waterloo-rocketry/Payload-2018/Software outline.docx

Software outline

Recovery board

3 main states, idle, active and armed

Idle State

- Only the Arduino and xbee are on

Active state

- Recovery Arduino is on, power is supplied to instrumentation board
- Stratologger is off
- Used to allow GPS to get a lock, and test datalogging

Armed state

- Same as active state but with stratologger on

Main loop

1. Check for data from transponder
2. If there is data
  a. Parse command from data
  b. If command is a state change
    i. Change state to new state
  c. Else do nothing
3. Check state
4. If state is idle
  a. Send
