waterloo-rocketry/Payload-2018/BOM.xlsx

Digikey Part # | Description | Quantity | Price per | Source | Total
 | Arduino nano 3 pack | 1 | $17.98 | https://www.amazon.ca/Gikfun-ATmega328-Micro-controller-Arduino-EK1620x3/dp/B00WS81CC2 | $17.98
CPC1002NTR | Solid State Relay | 3 | $2.38 | https://www.digikey.ca/product-detail/en/ixys-integrated-circuits-division/CPC1002NTR/CLA230CT-ND/1212841 | $7.14
XBP9B-XCUT-001 | Xbee | 3 | $54.30 | https://www.digikey.ca/product-detail/en/digi-international/XBP9B-XCUT-001/602-1295-ND/3043287 | $162.90
R-78E3.3-0.5 | 3.3V linear regulator | 3 | $3.71 | https://www.digikey.ca/products/en?keywords=R-78E3.3-0.5 | $11.13
PI4ULS5V201TAEX | Bidirectional shifter | 13 | $0.66 | https://www.digikey.ca/product-detail/en/diodes-incorporated/PI4ULS5V201TAEX/PI4ULS5V201TAEXCT-ND/4147077 | $8.58
08-50-0114 | 2 pin Molex pins | 36 | $0.24 | https://www.digikey.ca/product-detail/en/molex-llc/08-50-0114/WM1114-ND/26475 | $8.64
22-23-2021 | 2 pin molex male | 18 | $0.22 | https://www.digikey.ca/product-detail/en/molex-llc/22-23-2021/WM4200-ND/26667 | $3.96
22-01-2027 | 2 pin molex female | 18 | $0.14 | https://www.digikey.ca/product-detail/en/molex-llc/22-01-2027/WM2011-ND/171991 | $2.52
XC6201P302MR-G | 3V linear regulator | 2 | $0.98 | https://www.digikey.ca/product-detail/en/torex-semiconductor-ltd/XC6201P302MR-G/893-1189-1-ND/3906799 | $1.96
TPS71518DCKR | 1.8V linear regulator | 2 | $1.32 | https://www.digikey.ca/product-detail/en/texas-instruments/TPS71518DCKR/296-18731-1-ND/863553 | $2.64
 | MicroSD card reader | 2 | $9.68 | https://www.adafruit.com/product/254 | $19.36
 | GPS breakout board | 2 | $51.58 | https://www.adafruit.com/product/746 | $103.16
MS5607-02BA03 | Pressure Sensor | 1 | $4.42 | https://www.digikey.ca/product-detail/en/te-connectivity-measurement-specialties/MS560702BA03-50/223-1198-1-ND/4700921 | $4.42
LSM6DS3HTR | IMU | 2 | $5.98 | https://www.digikey.ca/product-detail/en/stmicroelectronics/LSM6DS3HTR/497-16367-1-ND/5872331 | $11.96
TEMT6000X01 | PhotoTransistor | 2 | $2.13 | https://www.digikey.ca/product-detail/en/vishay-semiconductor-opto-division/TEMT6000X01/751-1055-1-ND/1681410 | $4.26
VI0921550000G | 9 pin terminal | 1 | $3.10 | https://www.digikey.ca/product-detail/en/amphenol-anytek/VI0921550000G/609-3943-ND/2261377 | $3.10
66089-0906 | xbee payload antenna | 2 | $8.47 | https://www.digikey.ca/products/en?keywords=66089-0906 | $16.94
APAMS-118 | xbee whip antenna | 2 | $13.24 | https://www.digikey.ca/product-detail/en/abracon-llc/APAMS-118/535-12911-ND/5226432 | $26.48
S2B-PH-K-S(LF)(SN) | Right angle JST-PH | 6 | $0.24 | https://www.digikey.ca/products/en?keywords=455-1719-ND | $1.44
GF-124-0204 | transponder switch | 2 | $0.90 | https://www.digikey.ca/product-detail/en/cw-industries/GF-124-0204/CWI433-ND/4425718 | $1.80
PS1024ARED | transponder buttons | 3 | $4.14 | https://www.digikey.ca/product-detail/en/e-switch/RP3502MARED/EG1938-ND/280456 | $12.42
 | Li-ion batteries | 2 | $12.85 | https://www.adafruit.com/product/1781 | $25.70
PPPC051LFBN-RC | 5 position female header | 9 | $0.68 | https://www.digikey.ca/product-detail/en/sullins-connector-solutions/PPPC051LFBN-RC/S7038-ND/810177 | $6.12
PPTC101LFBN-RC | 10 position female header | 12 | $0.90 | https://www.digikey.ca/product-detail/en/sullins-connector-solutions/PPTC101LFBN-RC/S7008-ND/810149 | $10.80
NPPN101BFCN-RC | 10 position xbee header | 6 | $1.36 | https://www.digikey.ca/product-detail/en/sullins-connector-solutions/NPPN101BFCN-RC/S5751-10-ND/804812 | $8.16
RMCF0805JT3K00 | 3k resistor | 5 | $0.15 | https://www.digikey.ca/product-detail/en/stackpole-electronics-inc/RMCF0805JT3K00/RMCF0805JT3K00CT-ND/1942566 | $0.75
RNCP0805FTD2K00 | 2k resistor | 5 | $0.15 | https://www.digikey.ca/product-detail/en/stackpole-electronics-inc/RNCP0805FTD2K00/RNCP0805FTD2K00CT-ND/2240576 | $0.75
RNCP0805FTD10K0 | 10k resistor | 7 | $0.15 | https://www.digikey.ca/product-detail/en/stackpole-electronics-inc/RNCP0805FTD10K0/RNCP0805FTD10K0CT-ND/2240601 | $1.05
RMCF0805JT220R | 220 resistor | 6 | $0.15 | https://www.digikey.ca/product-detail/en/stackpole-electronics-inc/RMCF0805JT220R/RMCF0805JT220RCT-ND/1942544 | $0.90
RMCF0805FT470R | 470 resistor | 5 | $0.15 | https://www.digikey.ca/product-detail/en/stackpole-electronics-inc/RMCF0805FT470R/RMCF0805FT470RCT-ND/1942356 | $0.75
ERJ-6GEY0R00V | 0 resistor | 13 | $0.15 | https://www.digikey.ca/product-detail/en/panasonic-electronic-components/ERJ-6GEY0R00V/P0.0ACT-ND/82955 | $1.95
RMCF0805JT1K20 | 1.2k resistor | 5 | $0.15 | https://www.digikey.ca/product-detail/en/stackpole-electronics-inc/RMCF0805JT1K20/RMCF0805JT1K20CT-ND/1942559 | $0.75
CC0805ZKY5V6BB106 | 10uF capacitor | 8 | $0.29 | https://www.digikey.ca/product-detail/en/yageo/CC0805ZKY5V6BB106/311-1355-1-ND/2103139 | $2.32
CC0805KKX7R7BB105 | 1uF capacitor | 7 | $0.25 | https://www.digikey.ca/product-detail/en/yageo/CC0805KKX7R7BB105/311-1365-1-ND/2103149 | $1.75
CC0805DRNPO9BN8R2 | 8.2pF capacitor | 5 | $0.14 | https://www.digikey.ca/product-detail/en/yageo/CC0805DRNPO9BN8R2/311-4156-1-ND/8025245 | $0.70
CL21F104ZBCNNNC | 0.1uF capacitor | 30 | $0.14 | https://www.digikey.ca/product-detail/en/samsung-electro-mechanics/CL21F104ZBCNNNC/1276-1007-1-ND/3889093 | $4.20
CL21B474KAFNNNG | 0.47uF capacitor | 4 | $0.14 | https://www.digikey.ca/product-detail/en/samsung-electro-mechanics/CL21B474KAFNNNG/1276-6480-1-ND/5958108 | $0.56
P160KNP-0FC25C10K | potentiometer | 2 | $1.06 | https://www.digikey.ca/product-detail/en/tt-electronics-bi/P160KNP-0FC25C10K/987-1729-ND/5957473 | $2.12
852 | ufl to coaxil | 2 | $5.50 | https://www.digikey.ca/product-detail/en/adafruit-industries-llc/852/1528-1929-ND/6827042 | $11.00
 |  |  | Total |  | $499.44
