waterloo-rocketry/Payload-2018/TestingPlan.xlsx

Subsystem | Test | Description | Complete?
Pressure Sensor | Altitude testing | Put the cubesat in a vacuum chamber, bring it to 15 thousand feet and observe that the altitude on the transponder is similar to the reading on the gauge in the chamber
Pressure Sensor | Speed testing | Put the cubesat in a vacuum chamber, bring it to 15 thousand feet and measure the time it takes to reach 15 thousand feet, comparing against speed measurements shown on the transponder. Then slowly release air from the chamber and measure the speed compared against the speed on the transponder
Accelerometers | Jolt test | Jolt the cubesat in all 3 axis, and check the logged SD card data to ensure it reflects the jolts. Also ensure that one of the accelerometers maxes out at 4g and one at 16g
Thermistors | Temp Test | Put the cubesat in the heat chamber, bring it up to 70C and ensure all the thermistors are reading 70C. Also ensure that no electronics stop functioning due to the heat
GPS | GPS fix test | Turn on the cubesat and measure the time for the GPS to get a fix. Check the recorded coords on google maps to make sure they make sense. Disconnect the GPS and ensure the transponder shows no fix, and displays the last coords
Altimeter | Altimeter Arming | Turn the cubesat to armed mode and ensure that the altimeter turns on. Make sure that the transponder reflects that the altimeter is now on. Turn armed mode off and ensure the altimeter turns off, and that the transponder reflects this
Instr Board | Instr Board Arming | Turn on the instr board and ensure that it shows on the transponder that its on, turn it off and ensure that the transponder indicates this
Gyro Test | Roll Rate testing | Put the cubesat in the lathe (:monkas:) and ensure that the roll rate shown on the gyros makes sense
Radios | Radio Range testing | Get the furthest LOS in waterloo possible and see if you still have a connection
SD Cards | SD card testing | After running above tests, remove both SD cards and check data to show that it shows the data logged in the previous tests.
Altimeter | Altimeter Timeout | Turn on the altimeter, and leave the system for the timeout time (2 hours) and ensure it auto disarms
Batteries | Battery Life testing | Fully charge all batteries. Turn on the transponder and run until batteries die. Turn on the cubesat and run until batteries die. Recharge, turn on cubesat and enable all systems, then run until batteries die
Full system | Full Integration Test | Full integration and deployment test. Simulate Launch
