waterloo-rocketry/Payload-2018/PCBs/Recovery Board/Export/board_print.pdf

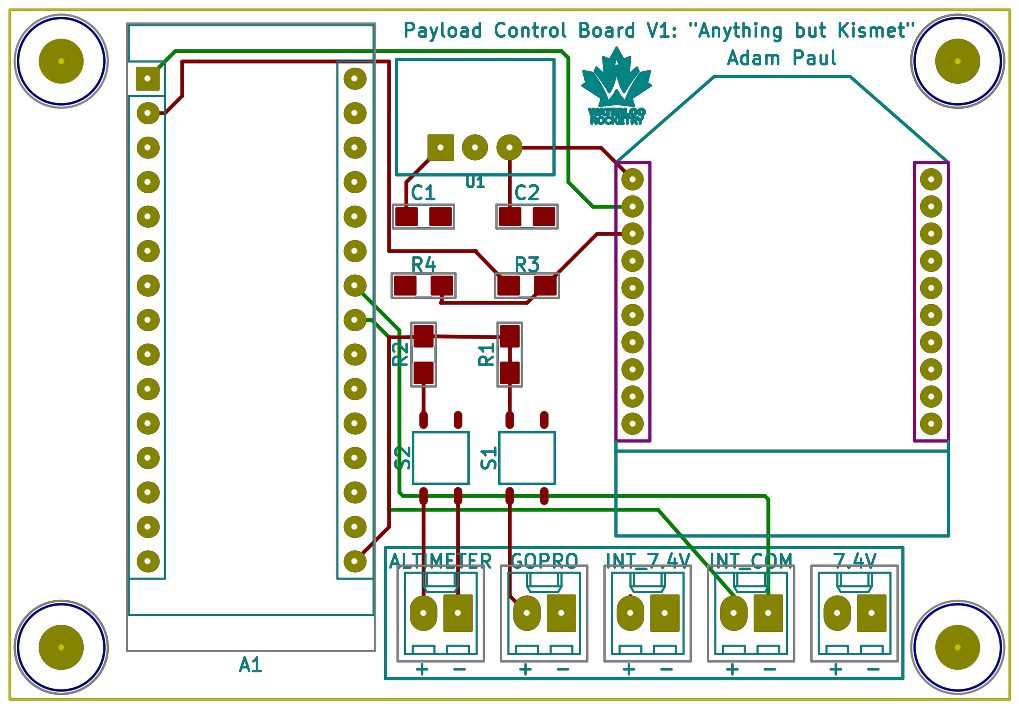
[picture p1: page 1]
