waterloo-rocketry/Payload-2018/PCBs/Recovery Board/Export/board1.pdf

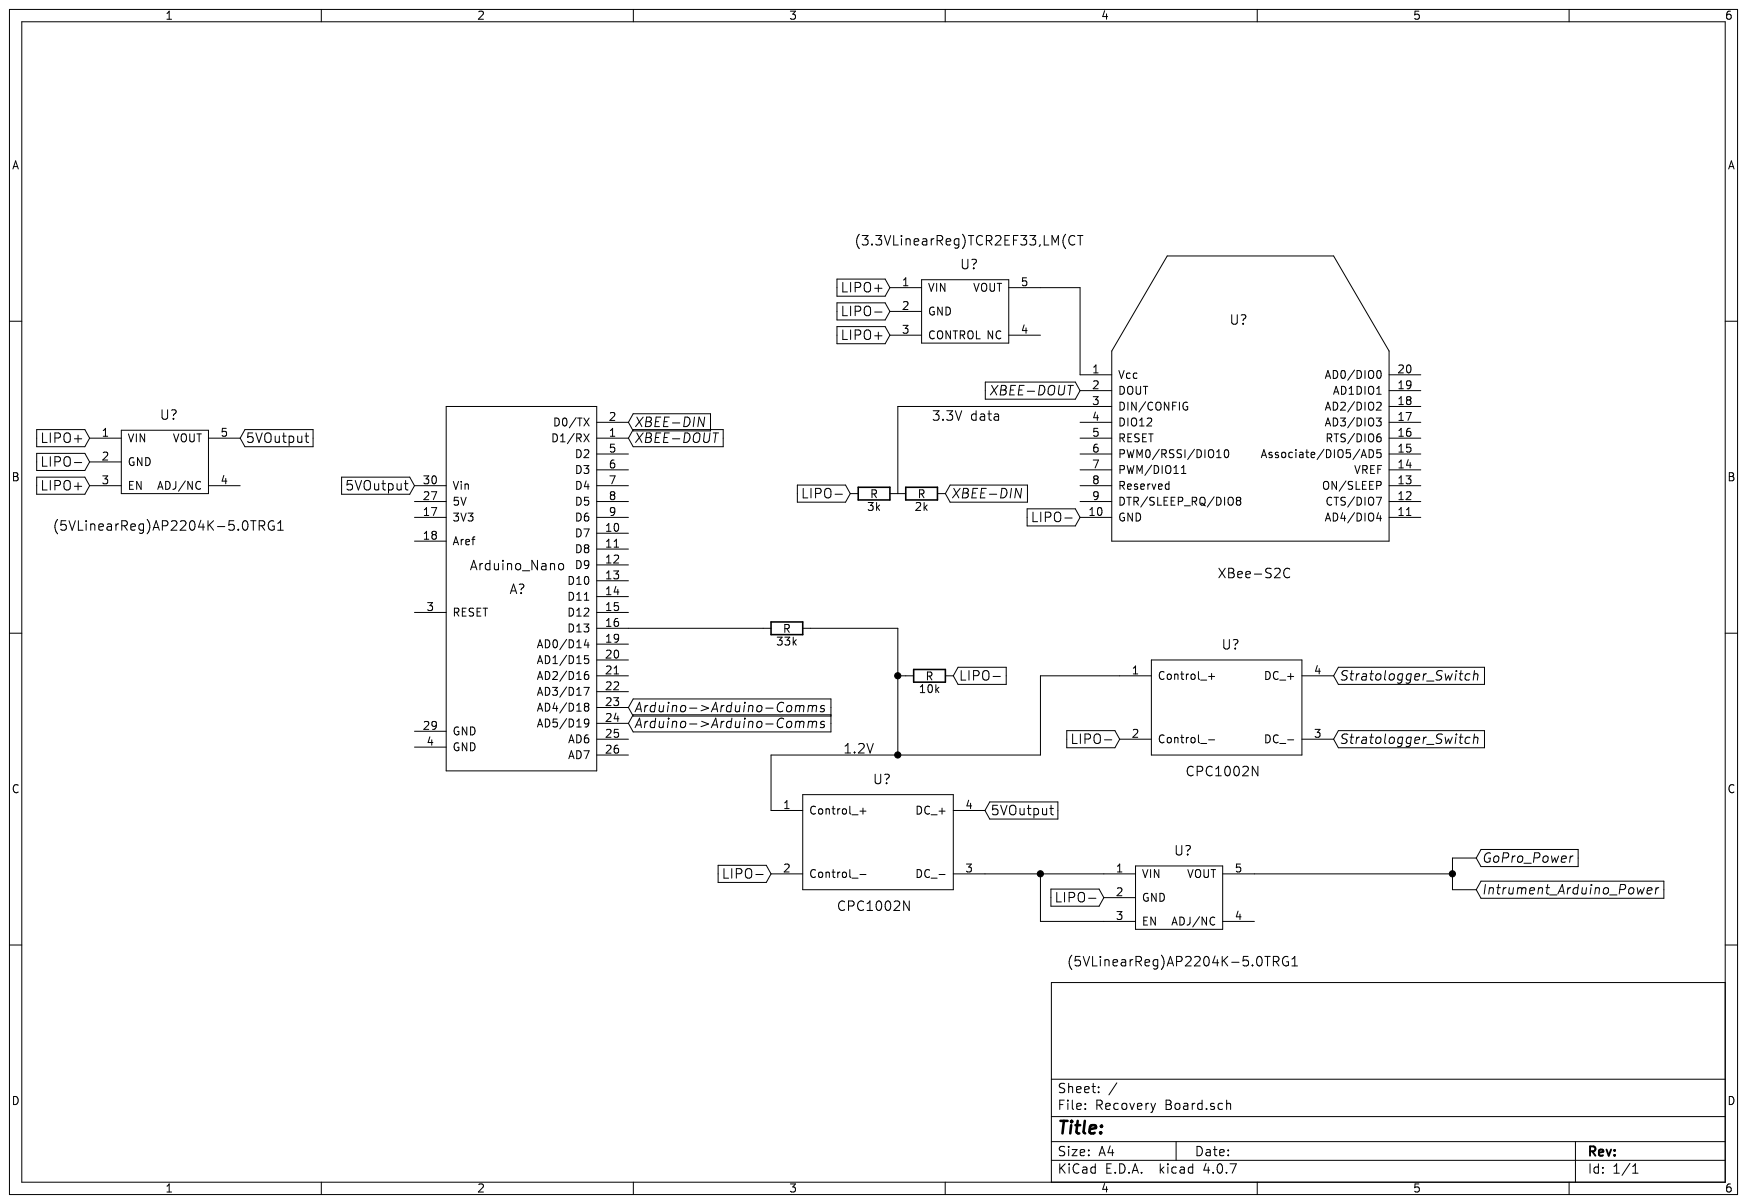
[picture p2: page 1]
