waterloo-rocketry/Payload-2018/PCBs/Recovery Board/Export/board1_rev3.pdf

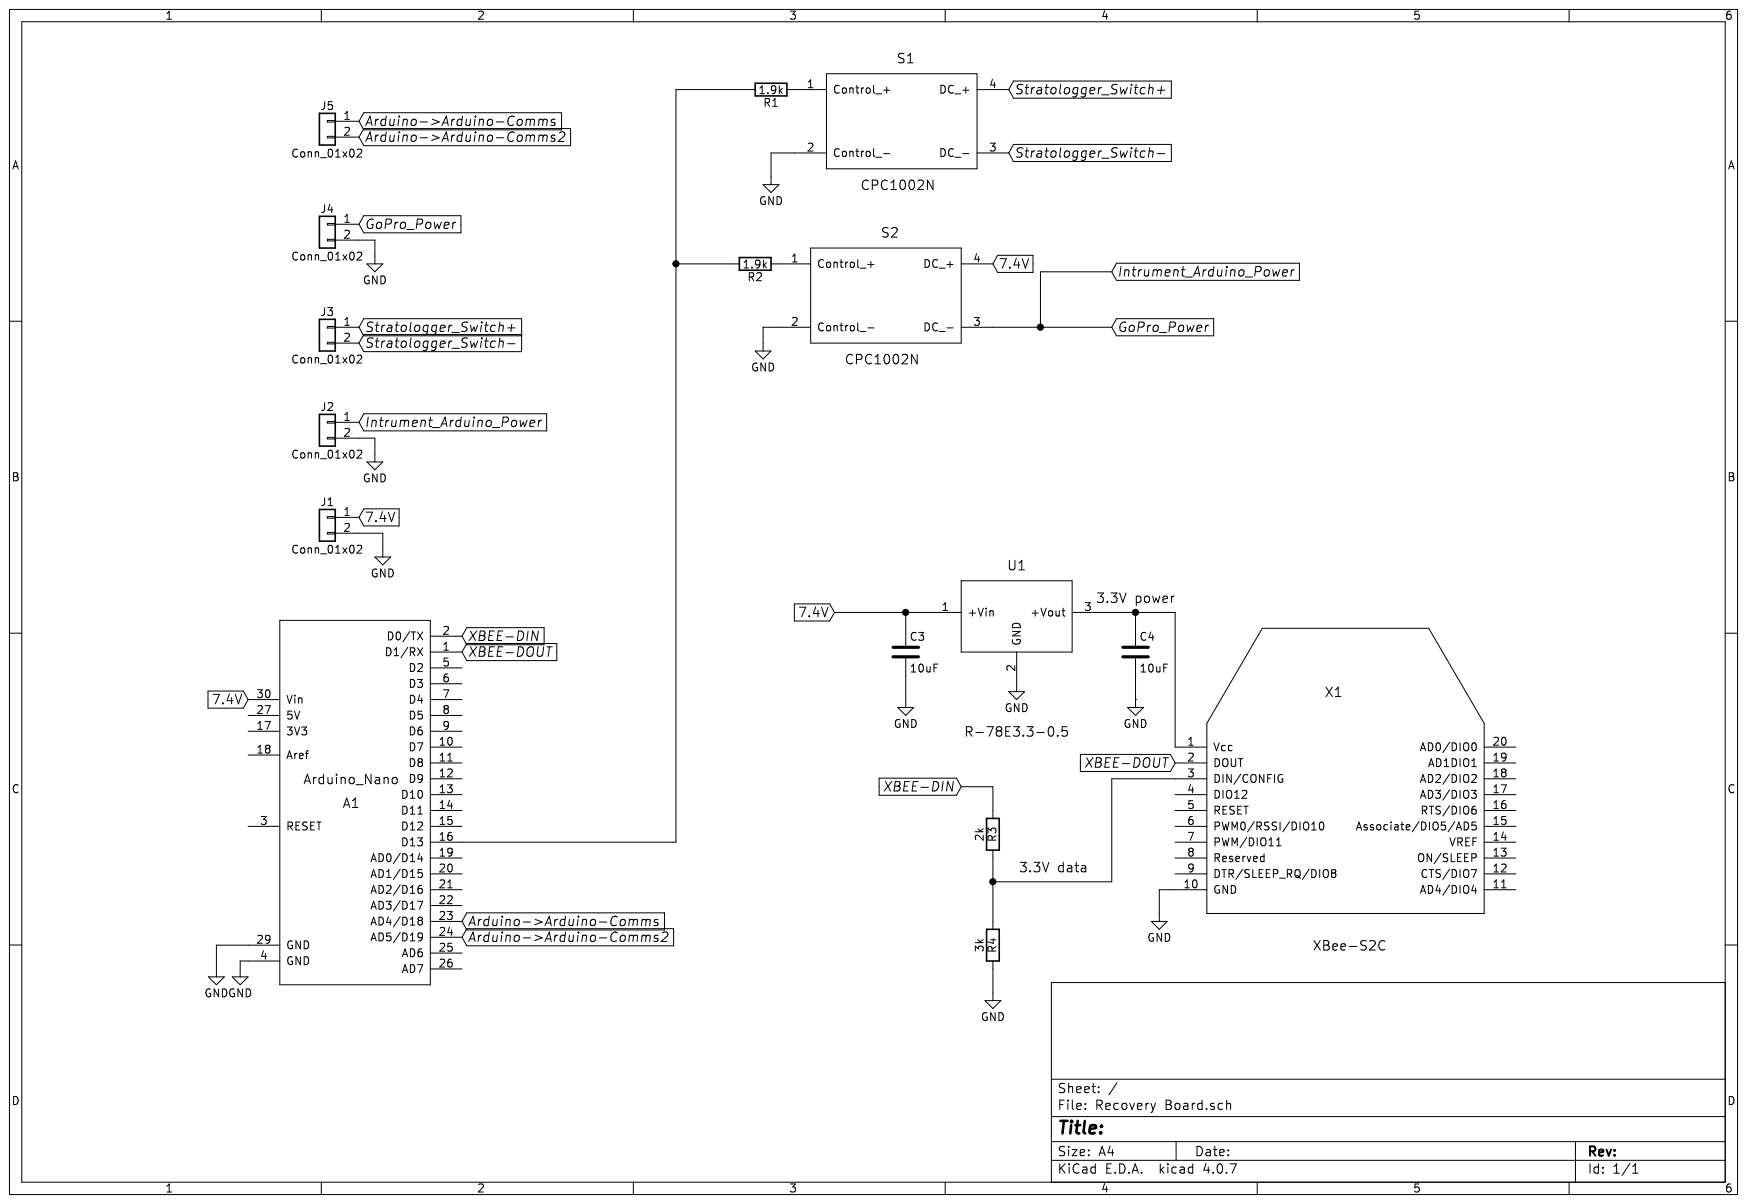
[picture p3: page 1]
