waterloo-rocketry/Payload-2018/PCBs/Recovery Board/Export/board1_rev1.pdf

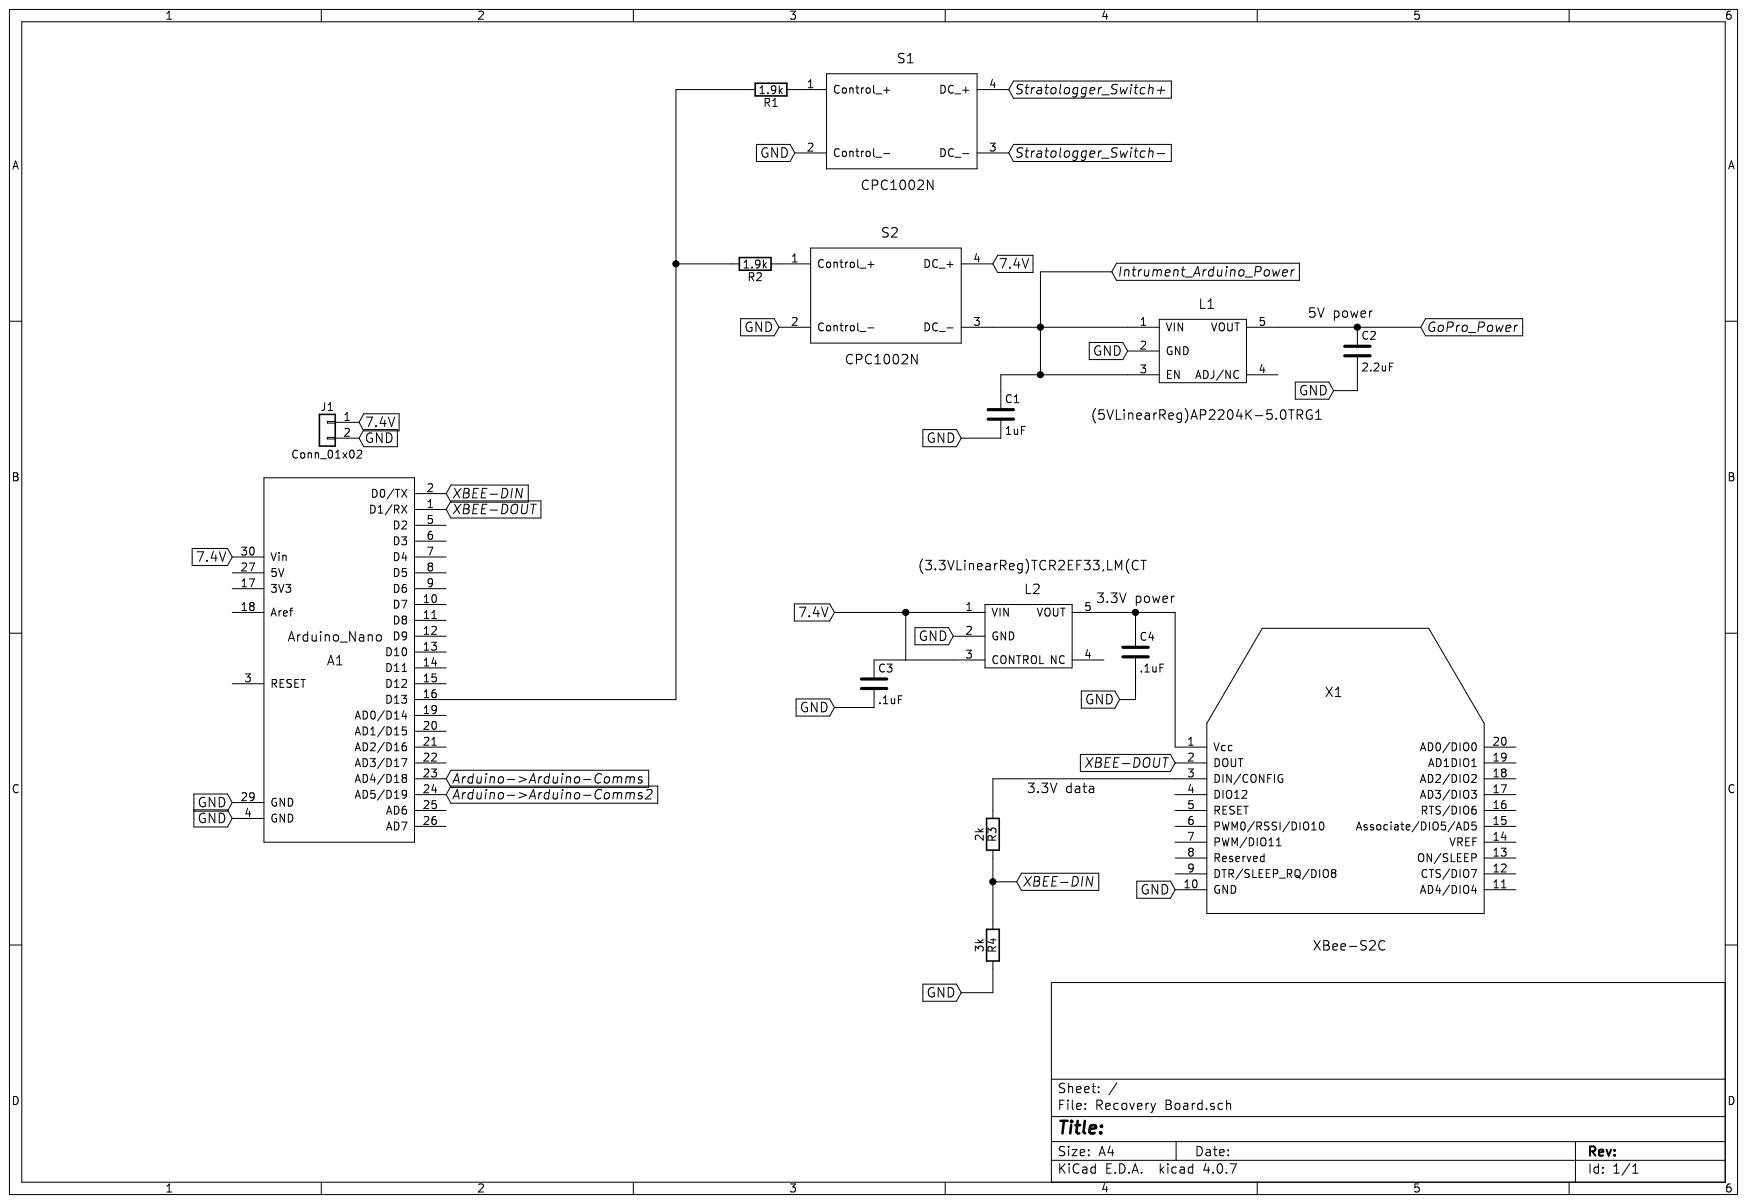
[picture p4: page 1]
