waterloo-rocketry/Payload-2018/PCBs/Recovery Board/Export/board1_rev2.pdf

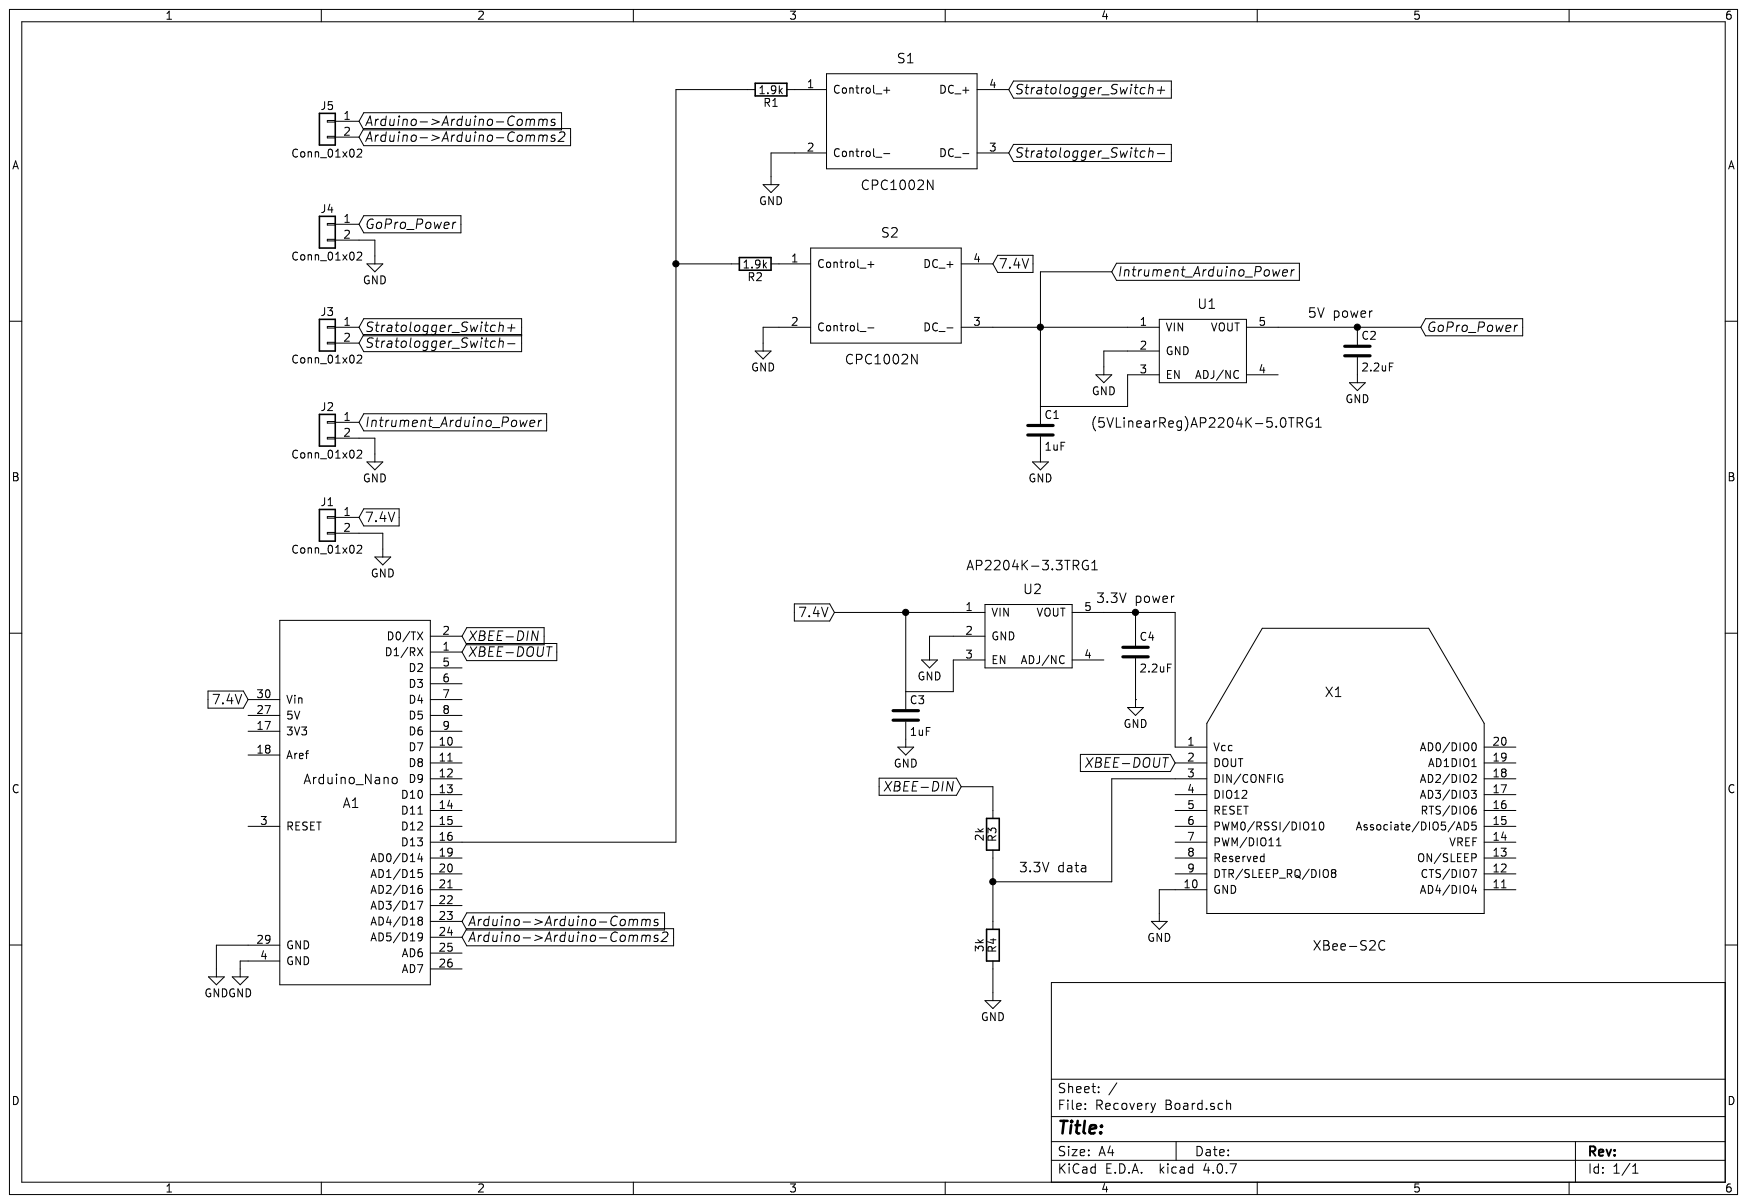
[picture p5: page 1]
