waterloo-rocketry/Payload-2018/PCBs/Recovery Board/Recovery Board.kicad_pcb

## KiCad design PCBs/Recovery Board/Recovery Board.kicad_pcb (2018-05-31)

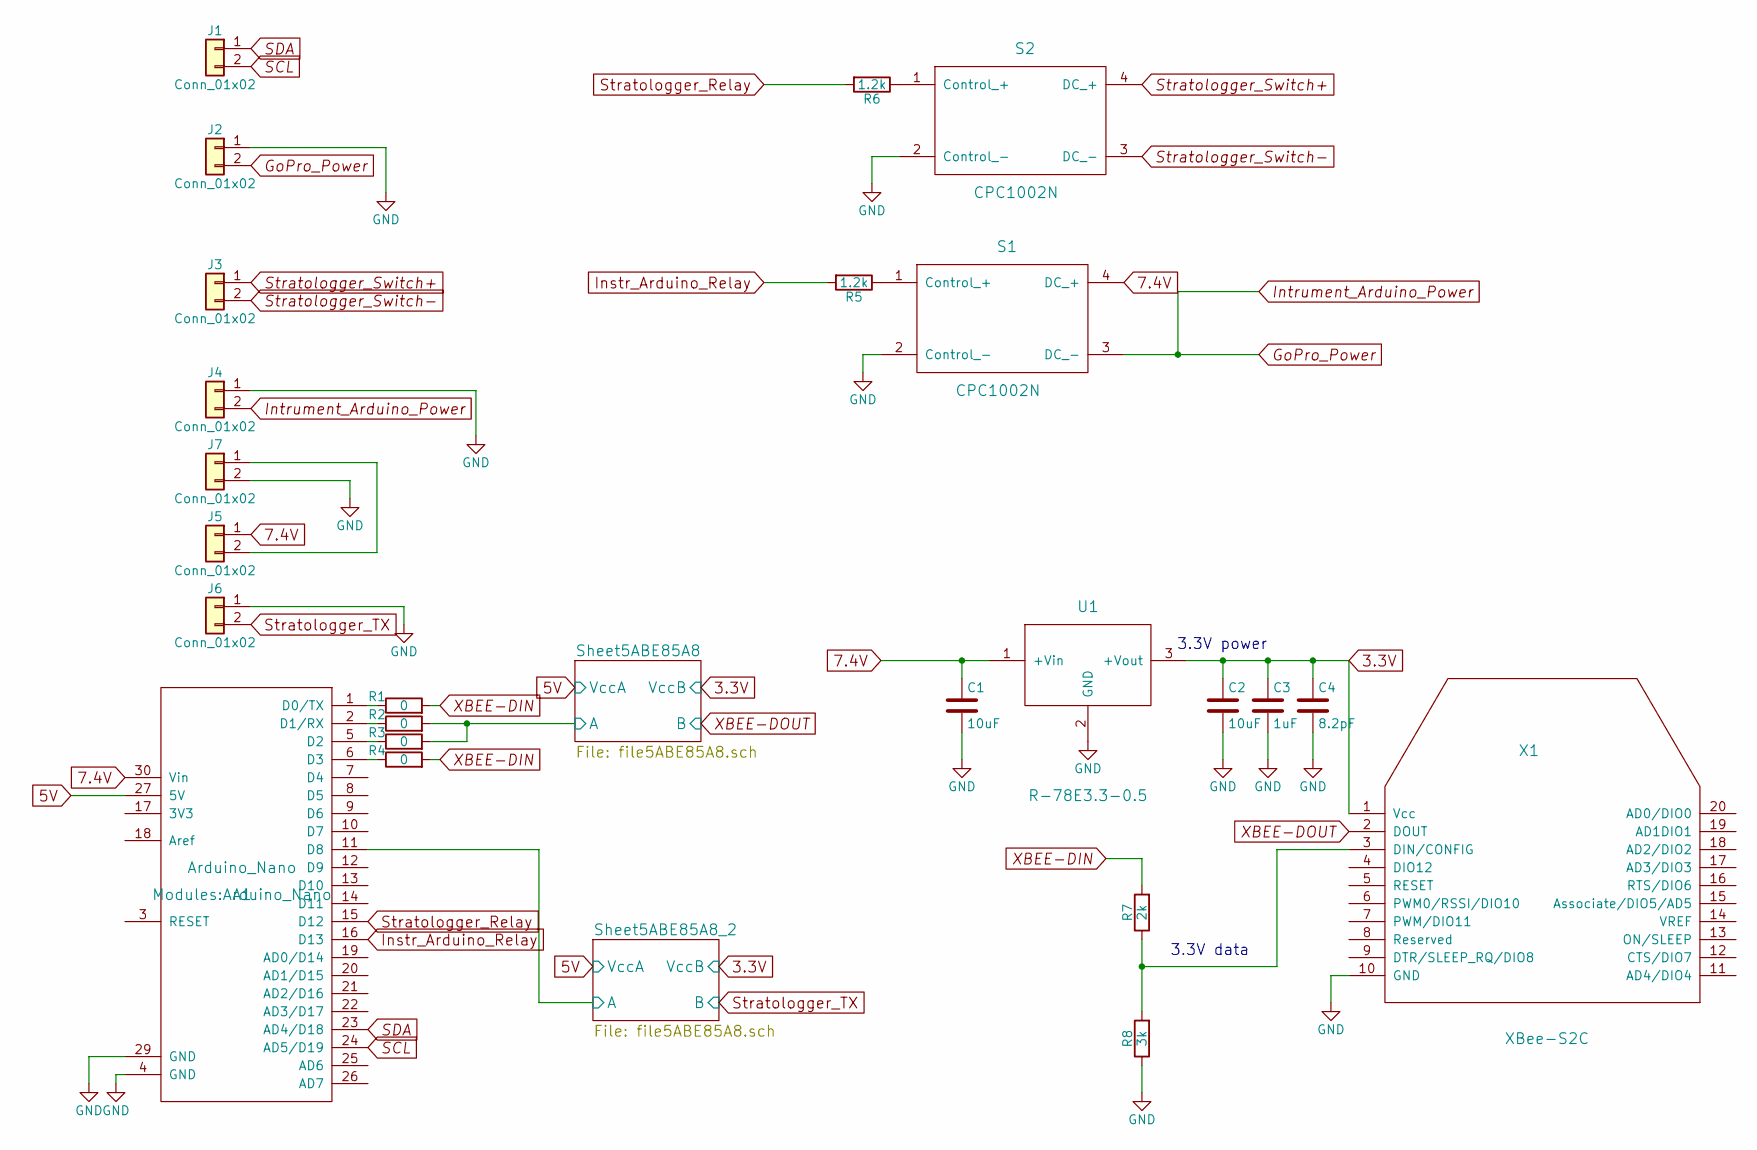
[picture p6: schematic Recovery Board.sch]

Parts:
A1: Arduino_Nano
C1, C2: 10uF; C_0805_HandSoldering
C3: 1uF; C_0805_HandSoldering
C4: 8.2pF; C_0805_HandSoldering
J1, J2, J3, J4, J6: Conn_01x02; molex_kk_22-23-2021
J5, J7: Conn_01x02; JST_PH_B2B-PH-K_02x2.00mm_Straight
R1, R2, R3, R4: 0; R_0805_HandSoldering
R5, R6: 1.2k; R_0805_HandSoldering
R7: 2k; R_0805_HandSoldering
R8: 3k; R_0805_HandSoldering
S1, S2: CPC1002N; CPC1002NTR
U1: R-78E3.3-0.5; SIP3
X1: XBee-S2C; XBEE-1

Connections:
3.3V: C2.1, C3.1, C4.1, U1.3 (+Vout), X1.1 (Vcc); also elsewhere on the board
5V: A1.27 (5V); also elsewhere on the board
7.4V: A1.30 (Vin), C1.1, J5.1, S1.4 (DC_+), U1.1 (+Vin)
/Sheet5ABE85A8/A: R2.2, R3.2; also elsewhere on the board
/Sheet5ABE85A8_2/A: A1.11 (D8); also elsewhere on the board
GND: A1.4 (GND), A1.29 (GND), C1.2, C2.2, C3.2, C4.2, J2.1, J4.1, J6.1, J7.2, R8.1, S1.2 (Control_-), S2.2 (Control_-), U1.2 (GND), X1.10 (GND); also elsewhere on the board
GoPro_Power: J2.2, J4.2, S1.3 (DC_-)
Instr_Arduino_Relay: A1.16 (D13), R5.2
unnamed: A1.1 (D0/TX), R1.1
unnamed: A1.2 (D1/RX), R2.1
unnamed: A1.5 (D2), R3.1
unnamed: A1.6 (D3), R4.1
unnamed: J5.2, J7.1
unnamed: R5.1, S1.1 (Control_+)
unnamed: R6.1, S2.1 (Control_+)
unnamed: R7.1, R8.2, X1.3 (DIN/CONFIG)
SCL: A1.24 (AD5/D19), J1.2
SDA: A1.23 (AD4/D18), J1.1
Stratologger_Relay: A1.15 (D12), R6.2
Stratologger_Switch+: J3.1, S2.4 (DC_+)
Stratologger_Switch-: J3.2, S2.3 (DC_-)
Stratologger_TX: J6.2; also elsewhere on the board
XBEE-DIN: R1.2, R4.2, R7.2
XBEE-DOUT: X1.2 (DOUT); also elsewhere on the board

Notes on the sheet:
3.3V data
3.3V power

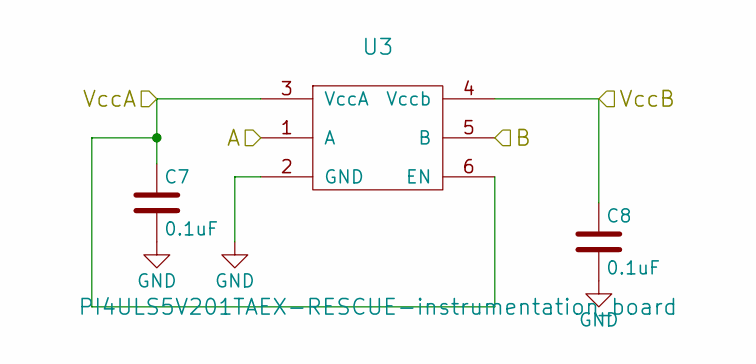
[picture p7: schematic file5ABE85A8.sch]

Parts:
C5, C6: 0.1uF; C_0805_HandSoldering
U2: PI4ULS5V201TAEX-RESCUE-instrumentation_board; SOT-23-6_Handsoldering

Connections:
3.3V: C6.1, U2.4 (Vccb); also elsewhere on the board
5V: C5.1, U2.3 (VccA), U2.6 (EN); also elsewhere on the board
/Sheet5ABE85A8/A: U2.1 (A); also elsewhere on the board
GND: C5.2, C6.2, U2.2 (GND); also elsewhere on the board
XBEE-DOUT: U2.5 (B); also elsewhere on the board

Parts of its further copies:
C7, C8: 0.1uF; C_0805_HandSoldering
U3: PI4ULS5V201TAEX-RESCUE-instrumentation_board; SOT-23-6_Handsoldering

Connections of its further copies:
3.3V: C8.1, U3.4 (Vccb); also elsewhere on the board
5V: C7.1, U3.3 (VccA), U3.6 (EN); also elsewhere on the board
/Sheet5ABE85A8_2/A: U3.1 (A); also elsewhere on the board
GND: C7.2, C8.2, U3.2 (GND); also elsewhere on the board
Stratologger_TX: U3.5 (B); also elsewhere on the board

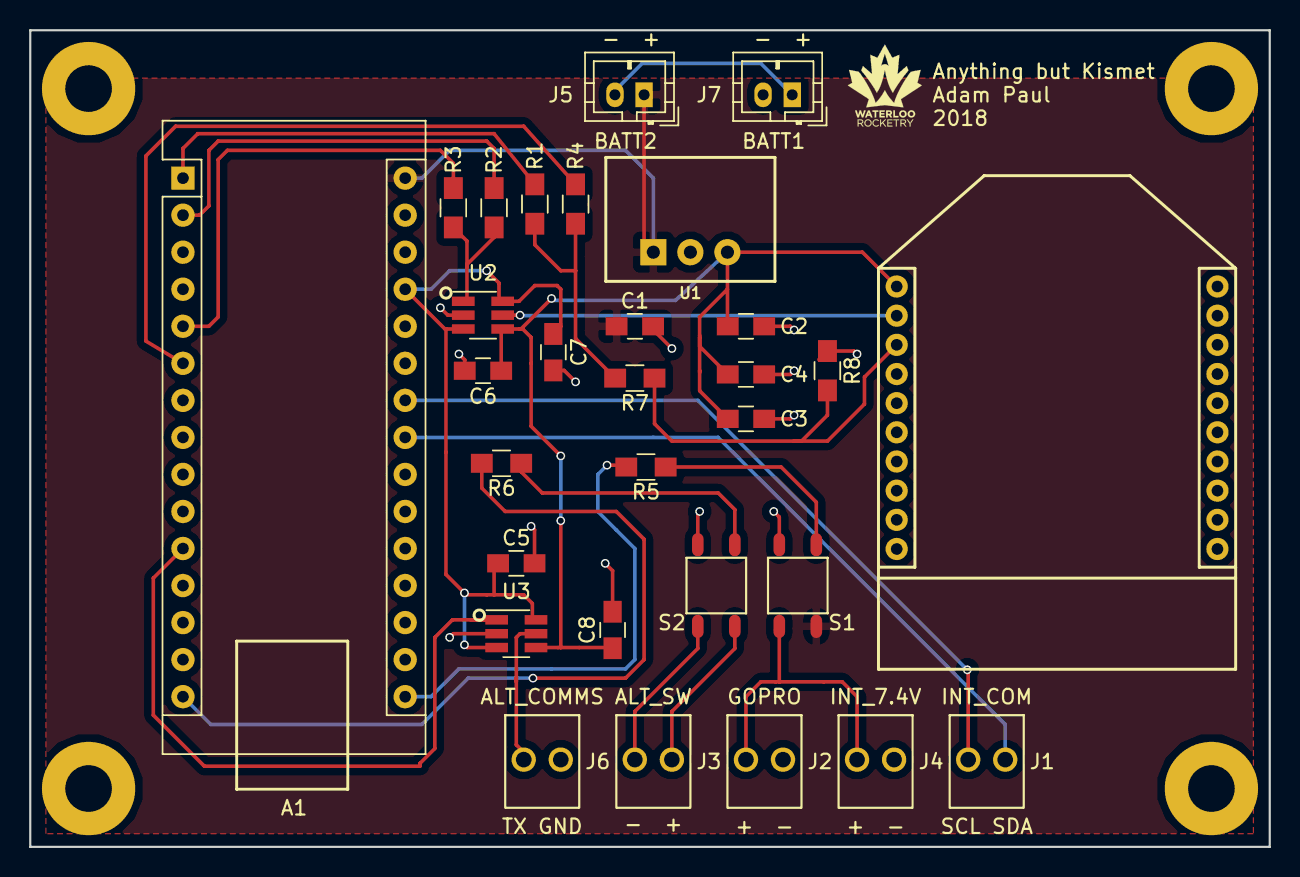
[picture p8: board Recovery Board.kicad_pcb from above]

Board: 2 copper layers, 85.0 x 56.0 mm, 30 parts (0 on the bottom side), 24 nets.
