waterloo-rocketry/Payload-2018/PCBs/Instrumentation Board/instrumentation_board.kicad_pcb

## KiCad design PCBs/Instrumentation Board/instrumentation_board.kicad_pcb (2018-05-10)

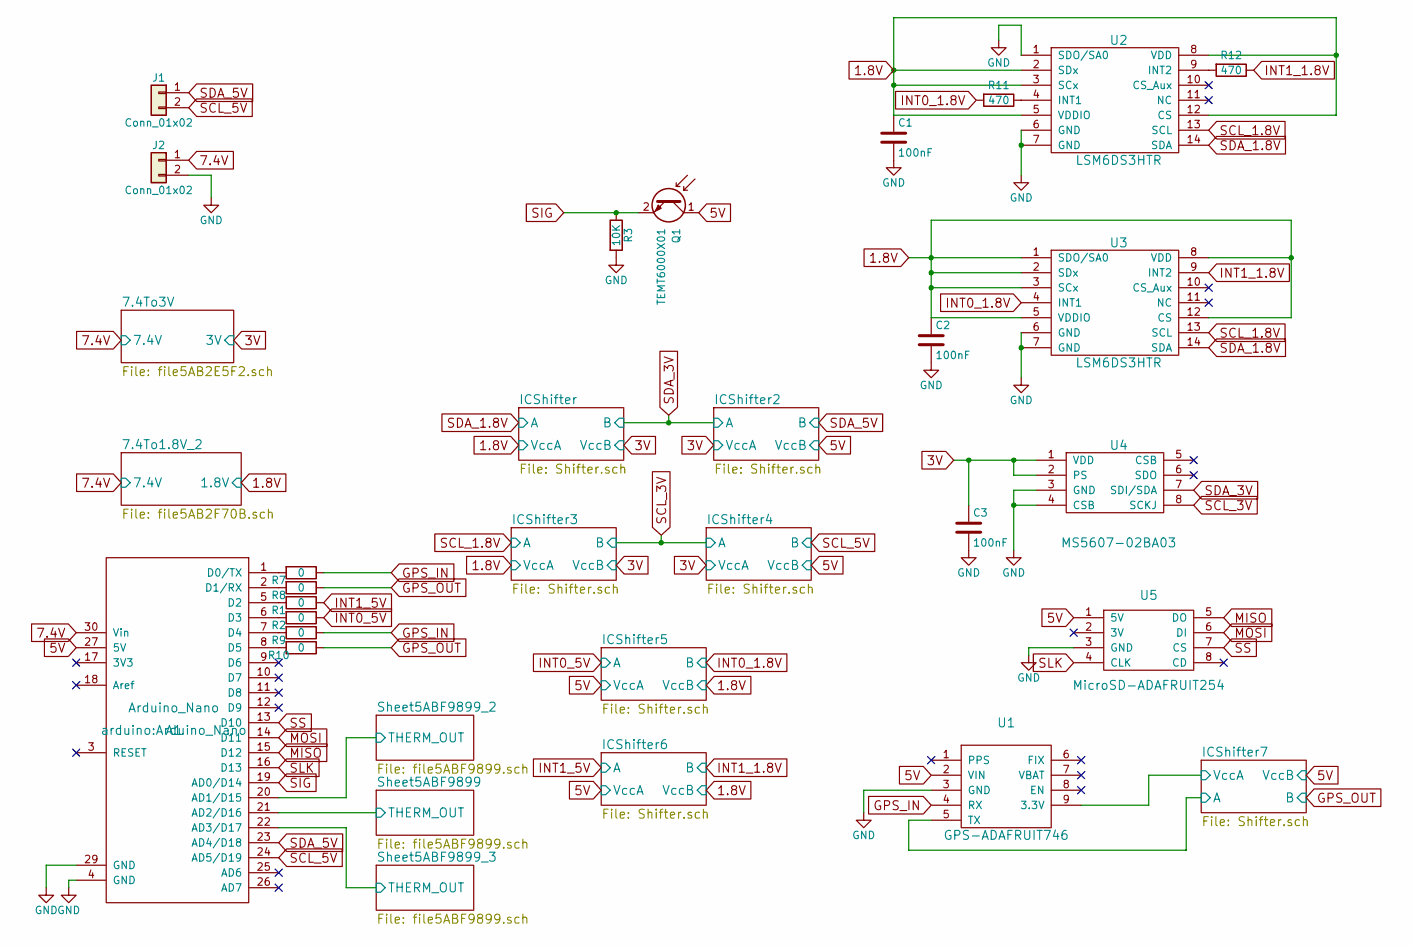
[picture p9: schematic instrumentation_board.sch]

Parts:
A1: Arduino_Nano
C1, C2, C3: 100nF; C_0805_HandSoldering
J1, J2: Conn_01x02; molex_kk_22-23-2021
Q1: TEMT6000X01
R1, R2, R7, R8, R9, R10: 0; R_0805_HandSoldering
R3: 10K; R_0805_HandSoldering
R11, R12: 470; R_0805_HandSoldering
U1: GPS-ADAFRUIT746; gps746
U2, U3: LSM6DS3HTR; LGA-14
U4: MS5607-02BA03; 8-SMD
U5: MicroSD-ADAFRUIT254; adafruit254

Connections:
1.8V: C1.1, C2.1, U2.2 (SDx), U2.3 (SCx), U2.5 (VDDIO), U2.8 (VDD), U2.12 (CS), U3.1 (SDO/SA0), U3.2 (SDx), U3.3 (SCx), U3.5 (VDDIO), U3.8 (VDD), U3.12 (CS); also elsewhere on the board
3V: C3.1, U4.1 (VDD), U4.2 (PS); also elsewhere on the board
5V: A1.27 (5V), Q1.1 (C), U1.2 (VIN), U5.1 (5V); also elsewhere on the board
7.4V: A1.30 (Vin), J2.1; also elsewhere on the board
/ICShifter7/A: U1.5 (TX); also elsewhere on the board
/ICShifter7/VccA: U1.9 (3.3V); also elsewhere on the board
/Sheet5ABF9899/THERM_OUT: A1.21 (AD2/D16); also elsewhere on the board
/Sheet5ABF9899_2/THERM_OUT: A1.20 (AD1/D15); also elsewhere on the board
/Sheet5ABF9899_3/THERM_OUT: A1.22 (AD3/D17); also elsewhere on the board
GND: A1.4 (GND), A1.29 (GND), C1.2, C2.2, C3.2, J2.2, R3.2, U1.3 (GND), U2.1 (SDO/SA0), U2.6 (GND), U2.7 (GND), U3.6 (GND), U3.7 (GND), U4.3 (GND), U4.4 (CSB), U5.3 (GND); also elsewhere on the board
GPS_IN: R7.1, R9.1, U1.4 (RX)
GPS_OUT: R8.1, R10.1; also elsewhere on the board
INT0_1.8V: R11.2, U3.4 (INT1); also elsewhere on the board
INT0_5V: R2.1; also elsewhere on the board
INT1_1.8V: R12.1, U3.9 (INT2); also elsewhere on the board
INT1_5V: R1.1; also elsewhere on the board
MISO: A1.15 (D12), U5.5 (DO)
MOSI: A1.14 (D11), U5.6 (DI)
unnamed: A1.1 (D0/TX), R7.2
unnamed: A1.2 (D1/RX), R8.2
unnamed: A1.5 (D2), R1.2
unnamed: A1.6 (D3), R2.2
unnamed: A1.7 (D4), R9.2
unnamed: A1.8 (D5), R10.2
unnamed: R11.1, U2.4 (INT1)
unnamed: R12.2, U2.9 (INT2)
SCL_1.8V: U2.13 (SCL), U3.13 (SCL); also elsewhere on the board
SCL_3V: U4.8 (SCKJ); also elsewhere on the board
SCL_5V: A1.24 (AD5/D19), J1.2; also elsewhere on the board
SDA_1.8V: U2.14 (SDA), U3.14 (SDA); also elsewhere on the board
SDA_3V: U4.7 (SDI/SDA); also elsewhere on the board
SDA_5V: A1.23 (AD4/D18), J1.1; also elsewhere on the board
SIG: A1.19 (AD0/D14), Q1.2 (E), R3.1
SLK: A1.16 (D13), U5.4 (CLK)
SS: A1.13 (D10), U5.7 (CS)

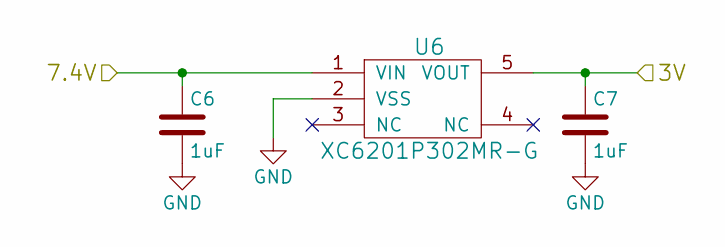
[picture p10: schematic file5AB2E5F2.sch]

Parts:
C6, C7: 1uF; C_0805_HandSoldering
U6: XC6201P302MR-G; SOT-23-5_HandSoldering

Connections:
3V: C7.1, U6.5 (VOUT); also elsewhere on the board
7.4V: C6.1, U6.1 (VIN); also elsewhere on the board
GND: C6.2, C7.2, U6.2 (VSS); also elsewhere on the board

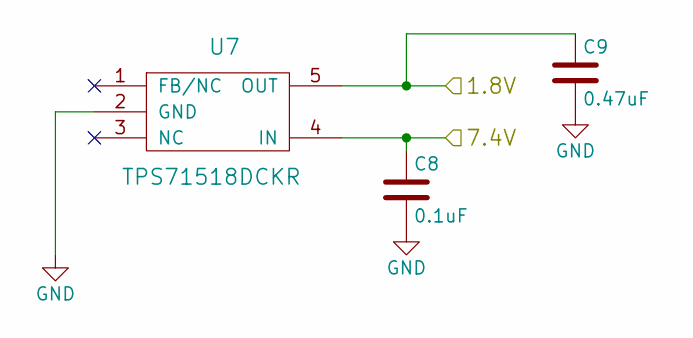
[picture p11: schematic file5AB2F70B.sch]

Parts:
C8: 0.1uF; C_0805_HandSoldering
C9: 0.47uF; C_0805_HandSoldering
U7: TPS71518DCKR; SOT-23-5_HandSoldering

Connections:
1.8V: C9.1, U7.5 (OUT); also elsewhere on the board
7.4V: C8.1, U7.4 (IN); also elsewhere on the board
GND: C8.2, C9.2, U7.2 (GND); also elsewhere on the board

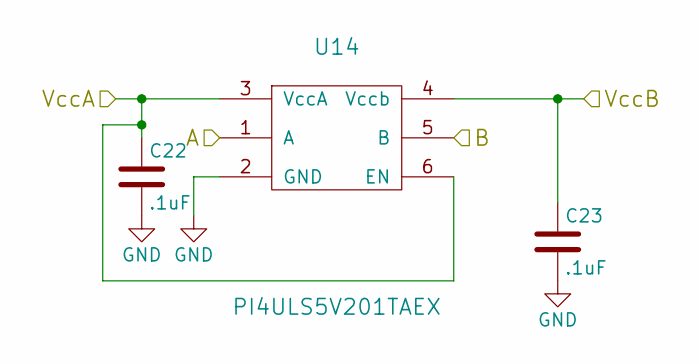
[picture p12: schematic Shifter.sch]

Parts:
C10, C11: .1uF; C_0805_HandSoldering
U8: PI4ULS5V201TAEX; SOT-23-6_Handsoldering

Connections:
3V: C10.1, U8.3 (VccA), U8.6 (EN); also elsewhere on the board
5V: C11.1, U8.4 (Vccb); also elsewhere on the board
GND: C10.2, C11.2, U8.2 (GND); also elsewhere on the board
SCL_3V: U8.1 (A); also elsewhere on the board
SCL_5V: U8.5 (B); also elsewhere on the board

Parts of its further copies:
C12, C13, C14, C15, C16, C17, C18, C19, C20, C21, C22, C23: .1uF; C_0805_HandSoldering
U9, U10, U11, U12, U13, U14: PI4ULS5V201TAEX; SOT-23-6_Handsoldering

Connections of its further copies:
1.8V: C12.1, C16.1, C21.1, C23.1, U9.3 (VccA), U9.6 (EN), U11.3 (VccA), U11.6 (EN), U13.4 (Vccb), U14.4 (Vccb); also elsewhere on the board
3V: C13.1, C14.1, C17.1, U9.4 (Vccb), U10.3 (VccA), U10.6 (EN), U11.4 (Vccb); also elsewhere on the board
5V: C15.1, C19.1, C20.1, C22.1, U10.4 (Vccb), U12.4 (Vccb), U13.3 (VccA), U13.6 (EN), U14.3 (VccA), U14.6 (EN); also elsewhere on the board
/ICShifter7/A: U12.1 (A); also elsewhere on the board
/ICShifter7/VccA: C18.1, U12.3 (VccA), U12.6 (EN); also elsewhere on the board
GND: C12.2, C13.2, C14.2, C15.2, C16.2, C17.2, C18.2, C19.2, C20.2, C21.2, C22.2, C23.2, U9.2 (GND), U10.2 (GND), U11.2 (GND), U12.2 (GND), U13.2 (GND), U14.2 (GND); also elsewhere on the board
GPS_OUT: U12.5 (B); also elsewhere on the board
INT0_1.8V: U13.5 (B); also elsewhere on the board
INT0_5V: U13.1 (A); also elsewhere on the board
INT1_1.8V: U14.5 (B); also elsewhere on the board
INT1_5V: U14.1 (A); also elsewhere on the board
SCL_1.8V: U9.1 (A); also elsewhere on the board
SCL_3V: U9.5 (B); also elsewhere on the board
SDA_1.8V: U11.1 (A); also elsewhere on the board
SDA_3V: U10.1 (A), U11.5 (B); also elsewhere on the board
SDA_5V: U10.5 (B); also elsewhere on the board

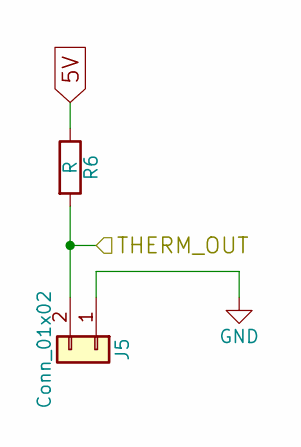
[picture p13: schematic file5ABF9899.sch]

Parts:
J3: Conn_01x02; molex_kk_22-23-2021
R4: R; R_0805_HandSoldering

Connections:
5V: R4.1; also elsewhere on the board
/Sheet5ABF9899_2/THERM_OUT: J3.2, R4.2; also elsewhere on the board
GND: J3.1; also elsewhere on the board

Parts of its further copies:
J4, J5: Conn_01x02; molex_kk_22-23-2021
R5, R6: R; R_0805_HandSoldering

Connections of its further copies:
5V: R5.1, R6.1; also elsewhere on the board
/Sheet5ABF9899/THERM_OUT: J4.2, R5.2; also elsewhere on the board
/Sheet5ABF9899_3/THERM_OUT: J5.2, R6.2; also elsewhere on the board
GND: J4.1, J5.1; also elsewhere on the board

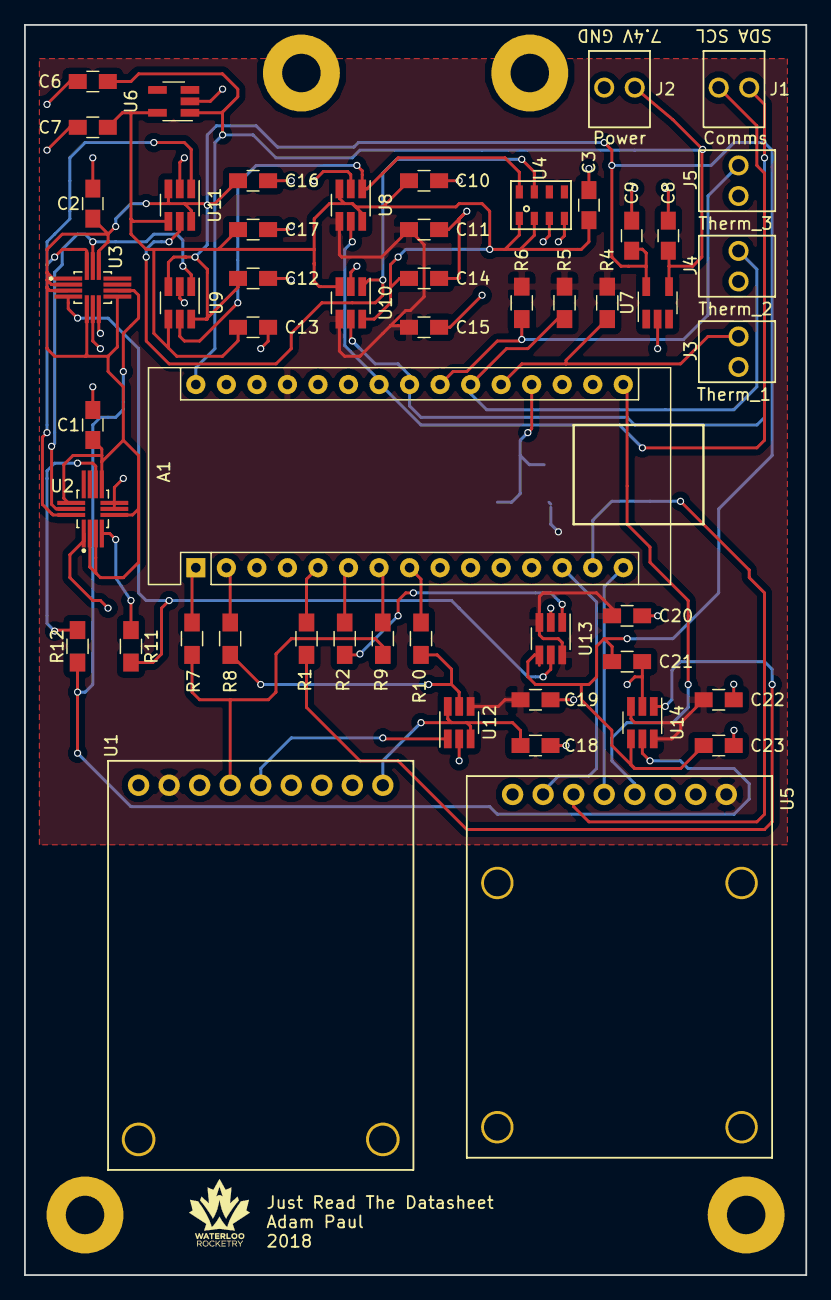
[picture p14: board instrumentation_board.kicad_pcb from above]

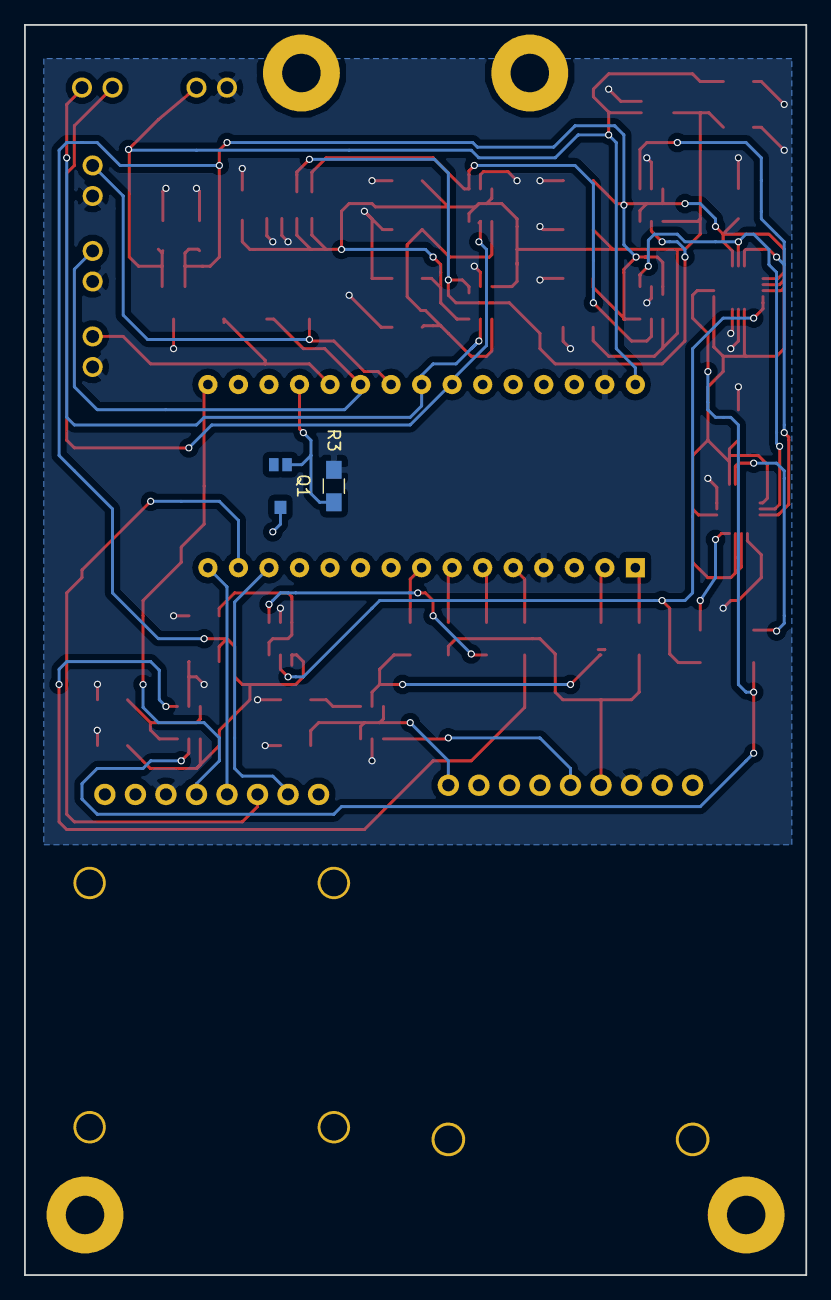
[picture p15: board instrumentation_board.kicad_pcb from below]

Board: 2 copper layers, 65.0 x 104.0 mm, 54 parts (2 on the bottom side), 35 nets.
