waterloo-rocketry/Payload-2018/PCBs/Transponder Board/Transponder.kicad_pcb

## KiCad design PCBs/Transponder Board/Transponder.kicad_pcb (2018-04-11)

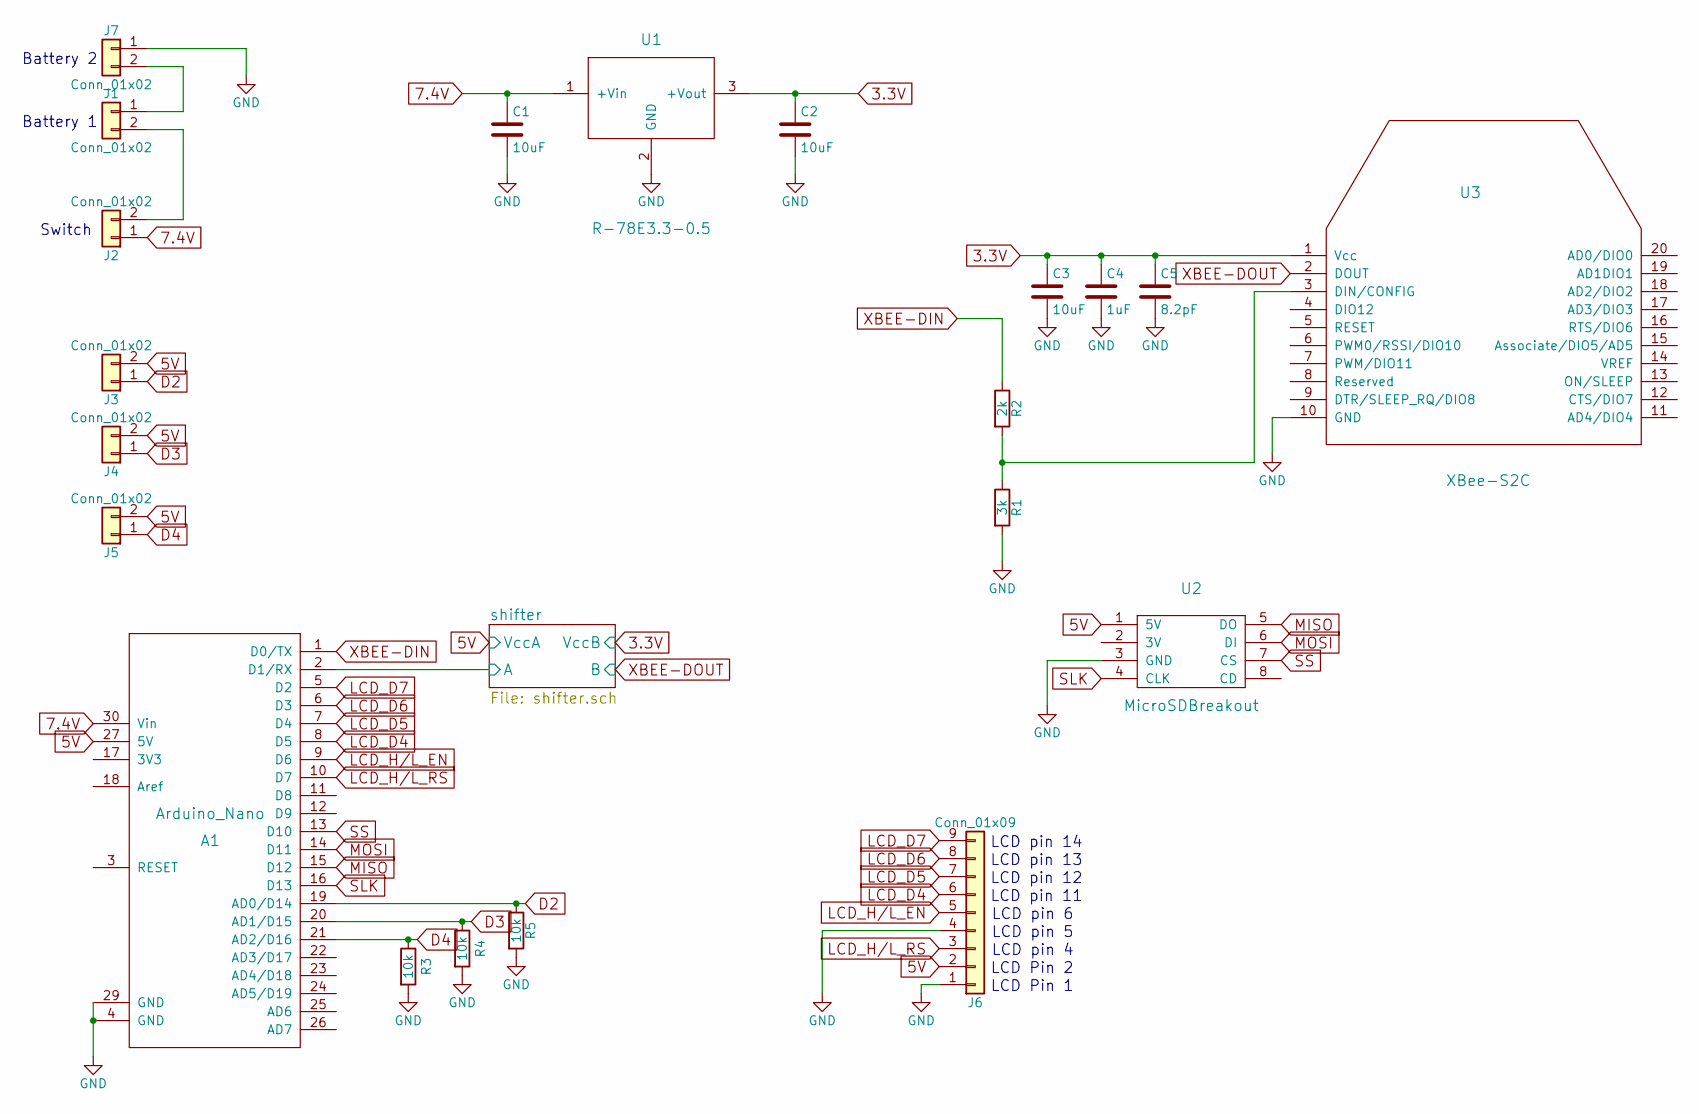
[picture p16: schematic Transponder.sch]

Parts:
A1: Arduino_Nano
C1, C2, C3: 10uF; C_0805_HandSoldering
C4: 1uF; C_0805_HandSoldering
C5: 8.2pF; C_0805_HandSoldering
J1, J7: Conn_01x02; JST_PH_B2B-PH-K_02x2.00mm_Straight
J2, J3, J4, J5: Conn_01x02; molex_kk_22-23-2021
J6: Conn_01x09; VI0921550000G
R1: 3k; R_0805_HandSoldering
R2: 2k; R_0805_HandSoldering
R3, R4, R5: 10k; R_0805_HandSoldering
U1: R-78E3.3-0.5; SIP3Large
U2: MicroSDBreakout; adafruit254
U3: XBee-S2C; XBEE-1

Connections:
3.3V: C2.1, C3.1, C4.1, C5.1, U1.3 (+Vout), U3.1 (Vcc); also elsewhere on the board
5V: A1.27 (5V), J3.2, J4.2, J5.2, J6.2, U2.1 (5V); also elsewhere on the board
7.4V: A1.30 (Vin), C1.1, J2.1, U1.1 (+Vin)
/shifter/A: A1.2 (D1/RX); also elsewhere on the board
D2: A1.19 (AD0/D14), J3.1, R5.1
D3: A1.20 (AD1/D15), J4.1, R4.1
D4: A1.21 (AD2/D16), J5.1, R3.1
GND: A1.4 (GND), A1.29 (GND), C1.2, C2.2, C3.2, C4.2, C5.2, J6.1, J6.4, J7.1, R1.2, R3.2, R4.2, R5.2, U1.2 (GND), U2.3 (GND), U3.10 (GND); also elsewhere on the board
LCD_D4: A1.8 (D5), J6.6
LCD_D5: A1.7 (D4), J6.7
LCD_D6: A1.6 (D3), J6.8
LCD_D7: A1.5 (D2), J6.9
LCD_H/L_EN: A1.9 (D6), J6.5
LCD_H/L_RS: A1.10 (D7), J6.3
MISO: A1.15 (D12), U2.5 (DO)
MOSI: A1.14 (D11), U2.6 (DI)
unnamed: J1.1, J7.2
unnamed: J1.2, J2.2
unnamed: R1.1, R2.2, U3.3 (DIN/CONFIG)
SLK: A1.16 (D13), U2.4 (CLK)
SS: A1.13 (D10), U2.7 (CS)
XBEE-DIN: A1.1 (D0/TX), R2.1
XBEE-DOUT: U3.2 (DOUT); also elsewhere on the board

Notes on the sheet:
LCD Pin 1
LCD Pin 2
LCD pin 4
LCD pin 5
LCD pin 6
LCD pin 11
LCD pin 12
LCD pin 13
LCD pin 14
Battery 1
Switch
Battery 2

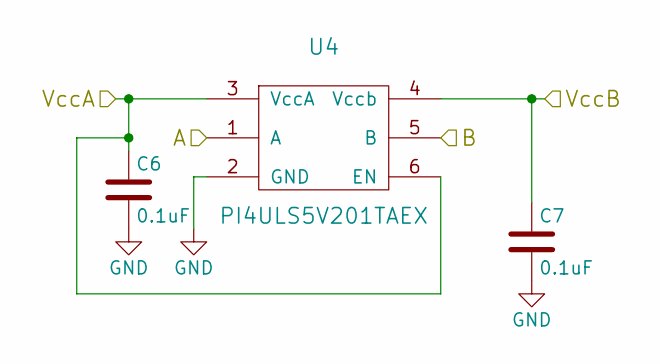
[picture p17: schematic shifter.sch]

Parts:
C6, C7: 0.1uF; C_0805_HandSoldering
U4: PI4ULS5V201TAEX; SOT-23-6_Handsoldering

Connections:
3.3V: C7.1, U4.4 (Vccb); also elsewhere on the board
5V: C6.1, U4.3 (VccA), U4.6 (EN); also elsewhere on the board
/shifter/A: U4.1 (A); also elsewhere on the board
GND: C6.2, C7.2, U4.2 (GND); also elsewhere on the board
XBEE-DOUT: U4.5 (B); also elsewhere on the board

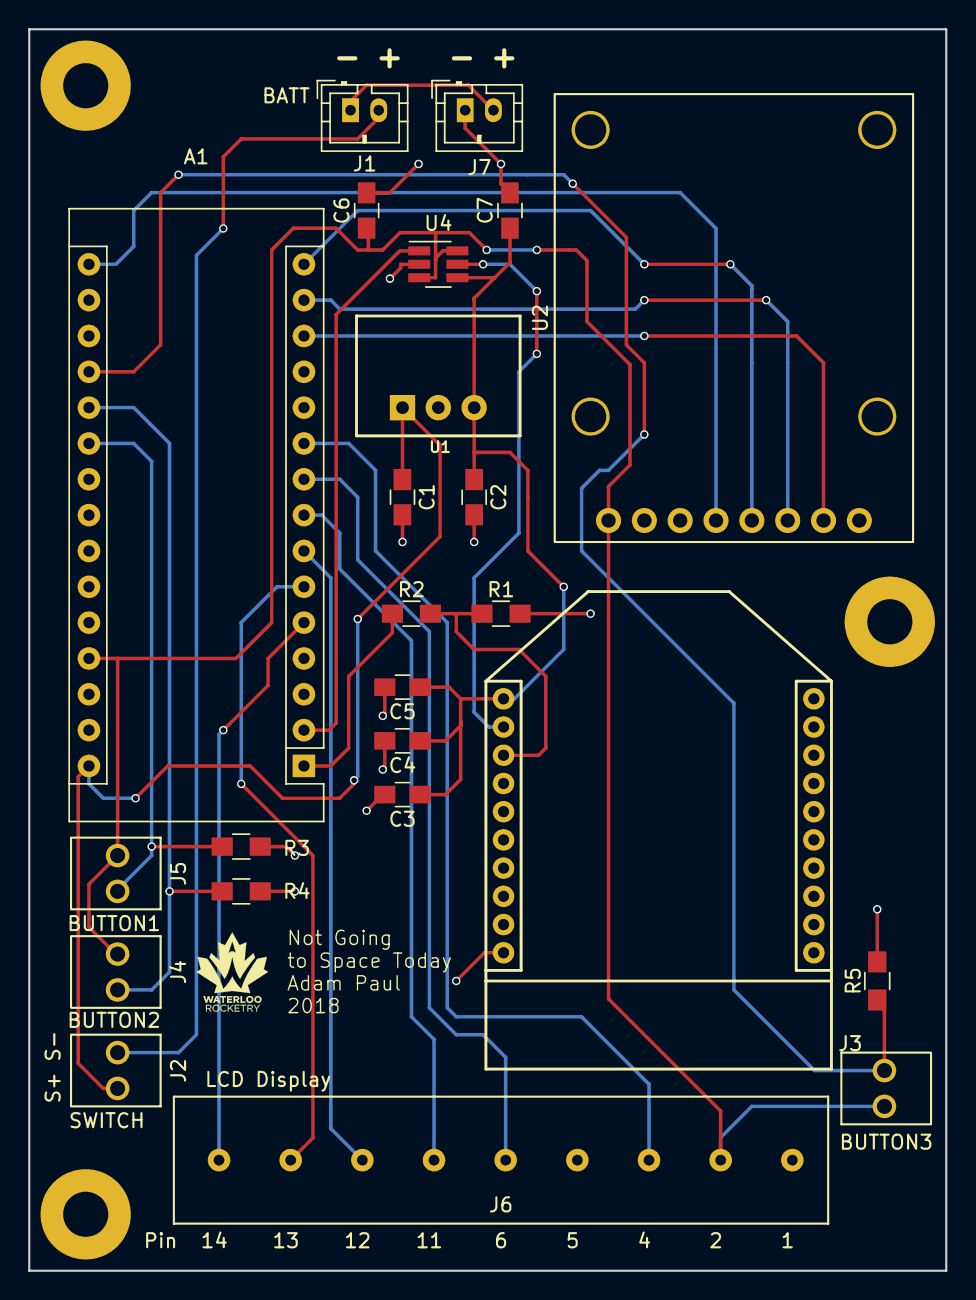
[picture p18: board Transponder.kicad_pcb from above]

Board: 2 copper layers, 65.0 x 88.0 mm, 24 parts (0 on the bottom side), 23 nets.
