waterloo-rocketry/Payload-2018/Code/InstrCode/InstrCode/PinRefs.h

#define AMBIENT_LIGHT_PIN A0

#define THERM_1_PIN 15
#define THERM_2_PIN 16
#define THERM_3_PIN 17

#define SLAVE_NUMBER 9

#define PRESSURE_SENSOR_ADDRESS 0xEE
