waterloo-rocketry/Payload-2018/Code/InstrCode/InstrCode/SDFileHeaders.h

#define SD_FILE_TO_WRITE F("Flight Data.csv")

#define TIME_HEADER F("Time since startup (ms)")
#define LIGHT_HEADER F("Ambient Light (0-1023)")
#define PRESSURE_HEADER F("Pressure (pA)")
#define PRESSURE_TEMP_HEADER F("Pressure sensor temp (0.01C)")

#define ACC_0_X_HEADER F("Accelerometer X (16g)")
#define ACC_0_Y_HEADER F("Accelerometer Y (16g)")
#define ACC_0_Z_HEADER F("Accelerometer Z (16g)")

#define GYRO_0_X_HEADER F("Gyroscope X")
#define GYRO_0_Y_HEADER F("Gyroscope Y")
#define GYRO_0_Z_HEADER F("Gyroscope Z")

#define ACC_1_X_HEADER F("Accelerometer X (4g)")
#define ACC_1_Y_HEADER F("Accelerometer Y (4g)")
#define ACC_1_Z_HEADER F("Accelerometer Z (4g)")

#define GYRO_1_X_HEADER F("Gyroscope X")
#define GYRO_1_Y_HEADER F("Gyroscope Y")
#define GYRO_1_Z_HEADER F("Gyroscope Z")

#define GPS_LAT_HEADER F("GPS Latitude")
#define GPS_LONG_HEADER F("GPS Longitude")

#define THERM_1_HEADER F("Inside Temp")
#define THERM_2_HEADER F("Outside Temp")
#define THERM_3_HEADER F("GoPro Temp")
