waterloo-rocketry/Payload-2018/Code/Recovery/RadioComms.ino

#include "RadioMessages.h"


String ReadFromSerial() {
	String inString = "";
	while (Serial.available()) {
		char inChar = (char)Serial.read();
		if (inChar == MESSAGE_BEGIN || inString != "") inString += inChar; //search for message begin
		if (inString != "" && inChar == MESSAGE_STOP) break;
	}
	return inString;
}

void ReadFromAltimeter() {
	String s = "";
	if (mySerial.available()) {
		altimeterOn = true;
	}
	else altimeterOn = false;

	while (mySerial.available()) {
		s = mySerial.read();
	}
	//if (s)
	//else altimeterOn = false;
}



void SendStateDataOverRadio() {
	Serial.print(MESSAGE_BEGIN);	//Send the current state of the cubesat to the ground
	Serial.print(DATA_MESSAGE);
	Serial.print(RECOVERY_SOURCE);
	Serial.print(STATE);
	Serial.print((int)state);
	Serial.print(DATA_STOP);
	Serial.print(MESSAGE_STOP);

	Serial.print(MESSAGE_BEGIN);
	Serial.print(DATA_MESSAGE);
	Serial.print(RECOVERY_SOURCE);
	Serial.print(ALTIMETER);
	Serial.print(altimeterOn ? 1 : 0);
	Serial.print(DATA_STOP);
	Serial.print(MESSAGE_STOP);
	Serial.flush();
}

void SendTimerDataOverRadio() {
	Serial.print(MESSAGE_BEGIN);
	Serial.print(DATA_MESSAGE);
	Serial.print(RECOVERY_SOURCE);
	Serial.print(ARMED_TIMER);
	Serial.print(((ArmedTimeout * 60000) - (millis() - ArmedCountdown)) / 60000);
	Serial.print(DATA_STOP);
	Serial.print(MESSAGE_STOP);
	Serial.flush();
}
/*
void SendInstrDataOverRadio() {
	if (i2cData == "") {
		Serial.print(MESSAGE_BEGIN);
		Serial.print(ERROR_MESSAGE);
		Serial.print(RECOVERY_SOURCE);
		Serial.print(INSTR_SOURCE);
		Serial.print(MESSAGE_STOP);
	}
	for (int i = 0; i < i2cData.length(); i++) {
		Serial.print(i2cData[i]);	//Pass on all data sent from instr board
	}
	i2cData = "";	//clear all data from instr board
	Serial.flush();
}
*/
