waterloo-rocketry/Payload-2018/Code/Transponder/Transponder/PinRefs.h

// Push Buttons
#define LeftButton 15
#define RightButton 14
#define SelectButton 16 //CHANGE THESE NUMBERS. ODDS ARE THEY ARE ALL SWITCHED

// LCD Buttons
#define RS 7
#define EN 6
#define D4 5
#define D5 4
#define D6 3
#define D7 2
