waterloo-rocketry/Payload-2018/(commit log)

2018-03-06 Fixed grounds and missing terminal
    [Recovery Board.kicad_pcb]
2018-03-08 Instrumentation board
    [Recovery Board.kicad_pcb, Recovery Board.sch, instrumentation_board.kicad_pcb, instrumentation_board.sch]
2018-03-13 Instrumentation board for review
    [instrumentation_board.sch]
2018-03-14 Changes requested by alex
    [Recovery Board.sch, Transponder.kicad_pcb, Transponder.sch, instrumentation_board.sch]
2018-03-21 added some new parts and i2c bus changes
    [Recovery Board.sch, bidirectionalshifter.sch, file5AB2E5F2.sch, file5AB2F70B.sch, instrumentation_board.sch]
2018-03-24 replace bidirectional shifters with ICs
    [bidirectionalshifter.sch, file5AB2E5F2.sch, file5AB2F70B.sch, instrumentation_board.sch]
2018-03-24 fixed swapped pins
    [Transponder.sch, instrumentation_board.sch]
2018-03-25 transponder board
    [Transponder.sch]
2018-03-26 changes as per Alex's review
    [Shifter.sch, bidirectionalshifter.sch, file5AB2E5F2.sch, file5AB2F70B.sch, instrumentation_board.sch]
2018-03-27 pinout changes
    [Recovery Board.kicad_pcb, Shifter.sch, Transponder.sch, file5AB2E5F2.sch, file5AB2F70B.sch, instrumentation_board.sch, shifter.sch]
2018-03-28 stashing changes
    [Recovery Board.kicad_pcb, Recovery Board.sch, _saved_Recovery Board.sch]
2018-03-28 Netlist Genorated
    Fixed multiple sheets with same name issue, generated netlist
    [Shifter.sch, file5AB2E5F2.sch, file5AB2F70B.sch, instrumentation_board.sch]
2018-03-28 Started instrumentation Netlist
    Finished footprints for shifter, regulators and IMUs
    [Shifter.sch, file5AB2E5F2.sch, file5AB2F70B.sch, instrumentation_board.sch]
2018-03-29 Continuing netlist
    Added barometric pressure sensor, started pattern for SD breakout board
    [instrumentation_board.sch]
2018-03-30 added various review changes
    [Recovery Board.sch, Shifter.sch, _saved_Recovery Board.sch, file5AB2E5F2.sch, file5AB2F70B.sch, file5ABE85A8.sch, file5ABF9899.sch, instrumentation_board.sch]
2018-03-30 swapped TX and RX pins
    [Recovery Board.sch, Shifter.sch, file5AB2E5F2.sch, file5AB2F70B.sch, file5ABE85A8.sch, file5ABF9899.sch, instrumentation_board.sch]
2018-03-30 weird merge
    [instrumentation_board.sch]
2018-03-30 Footprints updated
    [Shifter.sch, instrumentation_board.sch]
2018-03-31 Fixed weird merge issue (2)
    [Shifter.sch, file5ABF9899.sch, instrumentation_board.sch]
2018-03-31 Added BOM and software outline
    [BOM.xlsx, Transponder.sch, file5ABE85A8.sch]
2018-04-01 review changes + instr board PCB
    [Recovery Board.sch, Shifter.sch, file5AB2E5F2.sch, file5AB2F70B.sch, file5ABE85A8.sch, file5ABF9899.sch, instrumentation_board.sch, shifter.sch]
2018-04-01 finished traces on instr board
    [Shifter.sch, file5ABF9899.sch, instrumentation_board.kicad_pcb, instrumentation_board.sch]
2018-04-01 edge cuts and screw holes
    [instrumentation_board.kicad_pcb]
2018-04-03 Updated Recovery Netlist, started board updated layout
    [Recovery Board.kicad_pcb, Recovery Board.sch, file5ABE85A8.sch]
2018-04-03 completed layout for transponder board
    [BOM.xlsx, Transponder.sch, shifter.sch]
2018-04-04 Continued new recovery board layout
    [Recovery Board.kicad_pcb]
2018-04-04 rerouted payload instr board and completed all changes per Alexs review
    [Shifter.sch, Transponder.sch, file5AB2E5F2.sch, file5AB2F70B.sch, file5ABF9899.sch, instrumentation_board.kicad_pcb, instrumentation_board.sch]
2018-04-04 transponder changes as per Alexs review
    [Transponder.kicad_pcb, Transponder.sch, shifter.sch]
2018-04-04 fixed some outstanding instr issues, removed lots of vias
    [instrumentation_board.kicad_pcb]
2018-04-04 Finished updating recovery board layout
    board layout, schematic and netlist up to date
    [Recovery Board.kicad_pcb, Recovery Board.sch, file5ABE85A8.sch]
2018-04-05 fixed outstanding changes on instr and transponder board
    [Transponder.kicad_pcb, instrumentation_board.kicad_pcb]
2018-04-06 swapped all mounting holes with plated ones, fixed disconnected components on recovery, added the 4 decoupling caps to recovery, fixed silk screen on pads in instr, fixed traces connecting through pa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
    [Recovery Board.kicad_pcb, Recovery Board.sch, Transponder.kicad_pcb, file5ABE85A8.sch, instrumentation_board.kicad_pcb]
2018-04-07 Changed connectors for recovery board batteries
    Added a second connector for the other battery
    Moved connectors to top of board
    Replaced footprint with JST-PH
    Extended board width
    [Recovery Board.kicad_pcb, Recovery Board.sch, file5ABE85A8.sch]
2018-04-08 Changes to instr connectors
    Extended instr board length
    moved power connector to top of board
    removed I2C connector to top of board
    [Recovery Board.kicad_pcb, Transponder.kicad_pcb, instrumentation_board.kicad_pcb]
2018-04-08 Fixed instr and recovery components per Alexs review
    Added IMU current limiting resistors
    Moved the caps near J4 on instr
    Swapped out phototransistor footprint
    Flipped I2C silk screen on J1 recovery
    Flipped GND and TX silk screen on J6 recovery
    renamed strat to alt on recovery silk screen
    [BOM.xlsx, Recovery Board.kicad_pcb, Shifter.sch, file5ABF9899.sch, instrumentation_board.kicad_pcb, instrumentation_board.sch]
2018-04-09 Current limiting resistors
    Fixed structure of current limiting resistors on instr arduino
    [_saved_instrumentation_board.sch, instrumentation_board.kicad_pcb]
2018-04-09 Added Gerber Files
    [Recovery Board-B.Cu.gbl, Recovery Board-B.SilkS.gbo, Recovery Board-F.Cu.gtl, Recovery Board-F.SilkS.gto, Recovery Board.drl, Transponder-B.Cu.gbl, Transponder-B.Cu.gbr, Transponder-B.SilkS.gbo]
2018-04-10 Re-exported gerber
    [BOM.xlsx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]
2018-04-10 Connector Changes
    Flipped the transponder jst-ph connectors
    Replaced the molex footprint on recovery with the correct one
    [Recovery Board-B.Cu.gbl, Recovery Board-B.Mask.gbs, Recovery Board-B.SilkS.gbo, Recovery Board-Edge.Cuts.gm1, Recovery Board-F.Cu.gtl, Recovery Board-F.Mask.gts, Recovery Board-F.SilkS.gto, Recovery Board.drl]
2018-04-11 Re-Exported Gerber files with .05mm solder mask clearance
    [BOM.xlsx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]
2018-04-11 Added zips for gerber files
    [BOM.xlsx, Transponder.kicad_pcb]
2018-04-12 Updated BOM
    [BOM.xlsx]
2018-04-13 more BOM updating
    [BOM.xlsx]
2018-04-15 Final BOM
    [BOM.xlsx]
2018-04-16 Changes to PseudoCode
    Added a timer to turn off recovery after 1 hour
    Finished core update loop for instr
    Wrote all of transponder
2018-04-20 restucture of recovery code for new comm standard
    [BOM.xlsx]
2018-04-20 More recovery board code
2018-05-01 Started framework for instr board
2018-05-02 communication between instr board and transponder
2018-05-05 Added support for IMU and pressure sensors
2018-05-06 Added SD support for transponder board
2018-05-07 Changes to recovery board to fix found issues
    Swapped pin 1 & 2 on the CPC1002N relays
    Removed the screen from the back of the xbee pins
    Added an indicator for the install direction for arduino
    [Recovery Board.kicad_pcb]
2018-05-07 Changes to instr board from errors found
    Added a direction indicator to arduino
    Swapped the GPS pin order
    [instrumentation_board.kicad_pcb]
2018-05-10 New recovery gerbers
    [Recovery Board-B.Cu.gbl, Recovery Board-B.Mask.gbs, Recovery Board-B.SilkS.gbo, Recovery Board-Edge.Cuts.gm1, Recovery Board-F.Cu.gtl, Recovery Board-F.Mask.gts, Recovery Board-F.SilkS.gto, Recovery Board.drl]
2018-05-10 Fixed top level pour for recovery
    [Recovery Board-B.Cu.gbl, Recovery Board-B.Mask.gbs, Recovery Board-B.SilkS.gbo, Recovery Board-Edge.Cuts.gm1, Recovery Board-F.Cu.gtl, Recovery Board-F.Mask.gts, Recovery Board-F.SilkS.gto]
2018-05-19 Switched over GPS library to avoid I2C conflicts
    [InstrCode.ino, RadioMessages.h, RefreshStates.ino, SDOperations.ino, Transponder.ino, thermistor.cpp]
2018-05-24 added SD and 2nd IMU support to instr
2018-05-31 Fixed SD logic on instr side, added detection for a bad SD card on transponder side
    [Recovery Board.kicad_pcb]
2018-06-01 fixes for SD card transponder issues, added thermistors
    [InstrCode.ino, RadioComms.ino, RadioMessages.h, Recovery.ino, RefreshStates.ino, SDFileHeaders.h, SDOperations.ino, Transponder.ino]
2018-06-02 Added Testing Plan
    [TestingPlan.xlsx]
2018-06-16 pre-comp code lockdown
    [TestingPlan.xlsx]
