waterloo-rocketry/Payload-2018/(notices)

Notices in the files:
Code/InstrCode/InstrCode/thermistor.cpp:
panStamp is free software; you can redistribute it and/or modify
it under the terms of the GNU Lesser General Public License as published by
the Free Software Foundation; either version 3 of the License, or
any later version.
